jaedync/68Katalyst/README.md

# 68Katalyst

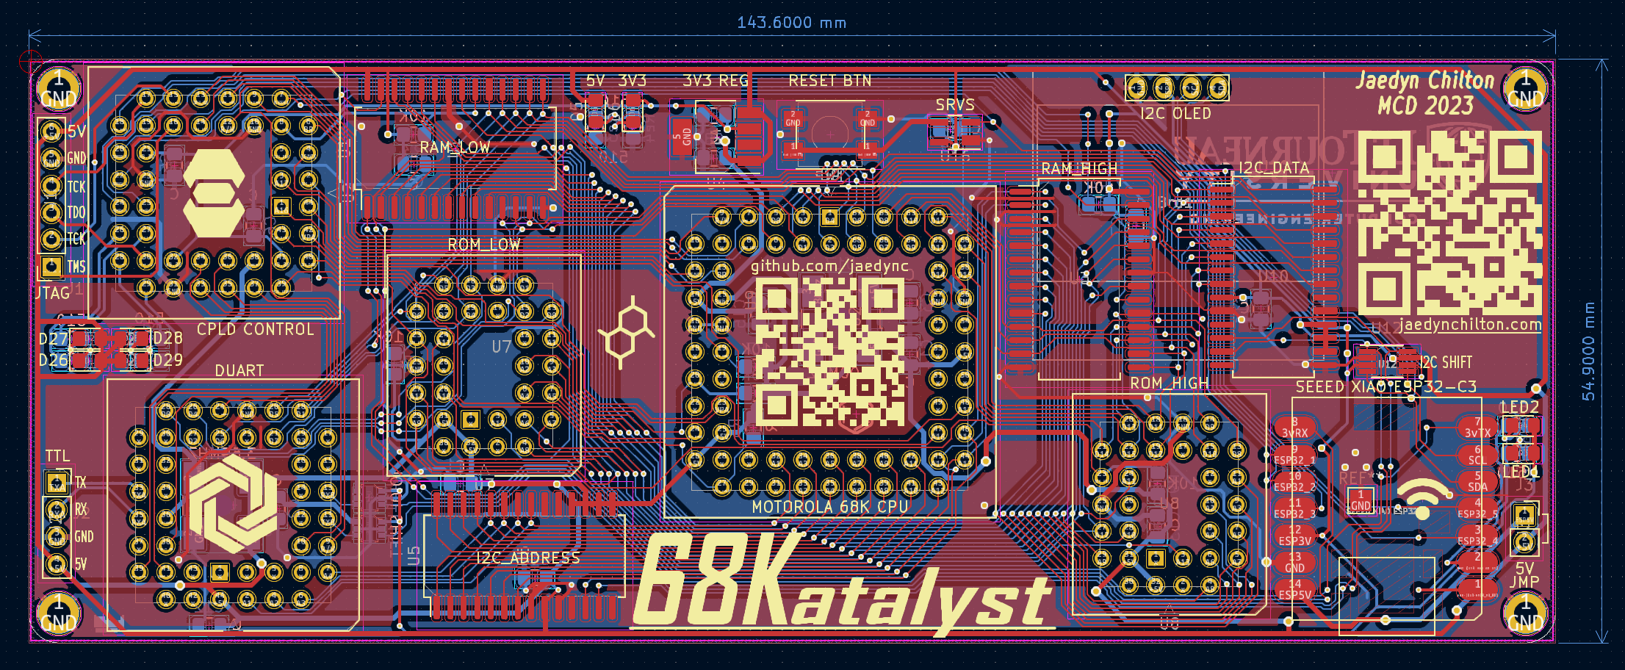
[picture p1: images/68Katalyst_PCB_Layers.png]
68Katalyst PCB Design


68Katalyst is a computer engineering project at Letourneau University. The goal is to create a turing complete 68k microcomputer that can commnicate over a serial connection.'

## Software used

- [KiCad](https://www.kicad.org/) PCB design software

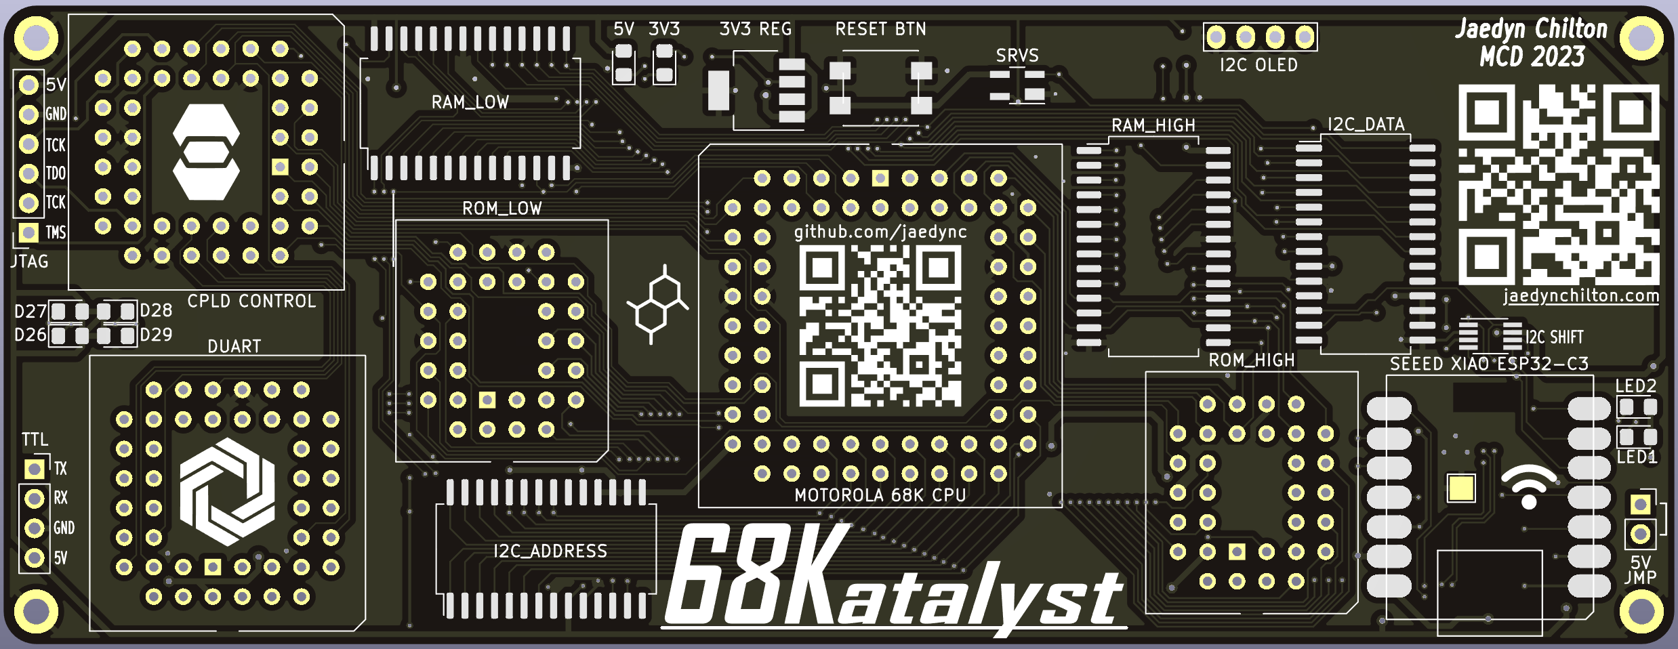
[picture p2: images/68Katalyst_PCB_Front.png]
PCB Front Render


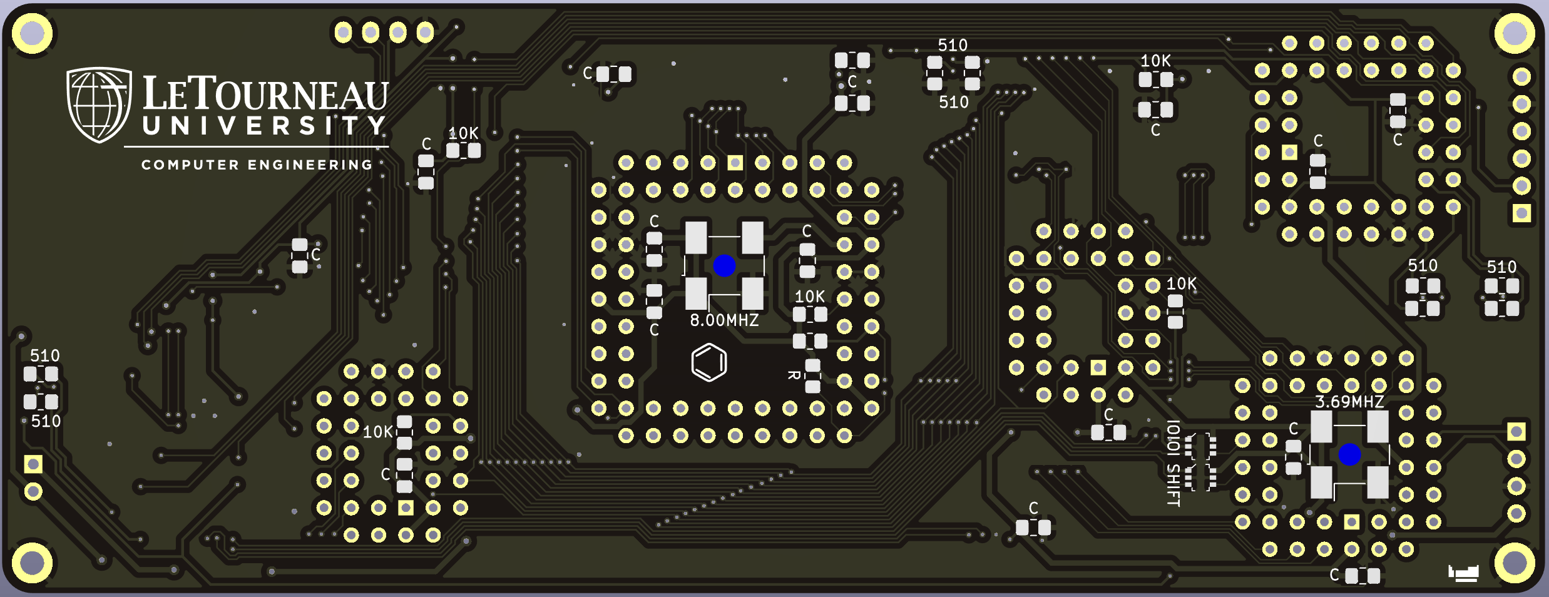
[picture p3: images/68Katalyst_PCB_Back.png]
PCB Back Render


## Contact Information

If you have any questions, feel free to reach out at me@jaedynchilton.com!
