jaedync/68Katalyst/MCD.kicad_pcb

## KiCad design MCD.kicad_pcb (2023-03-04)

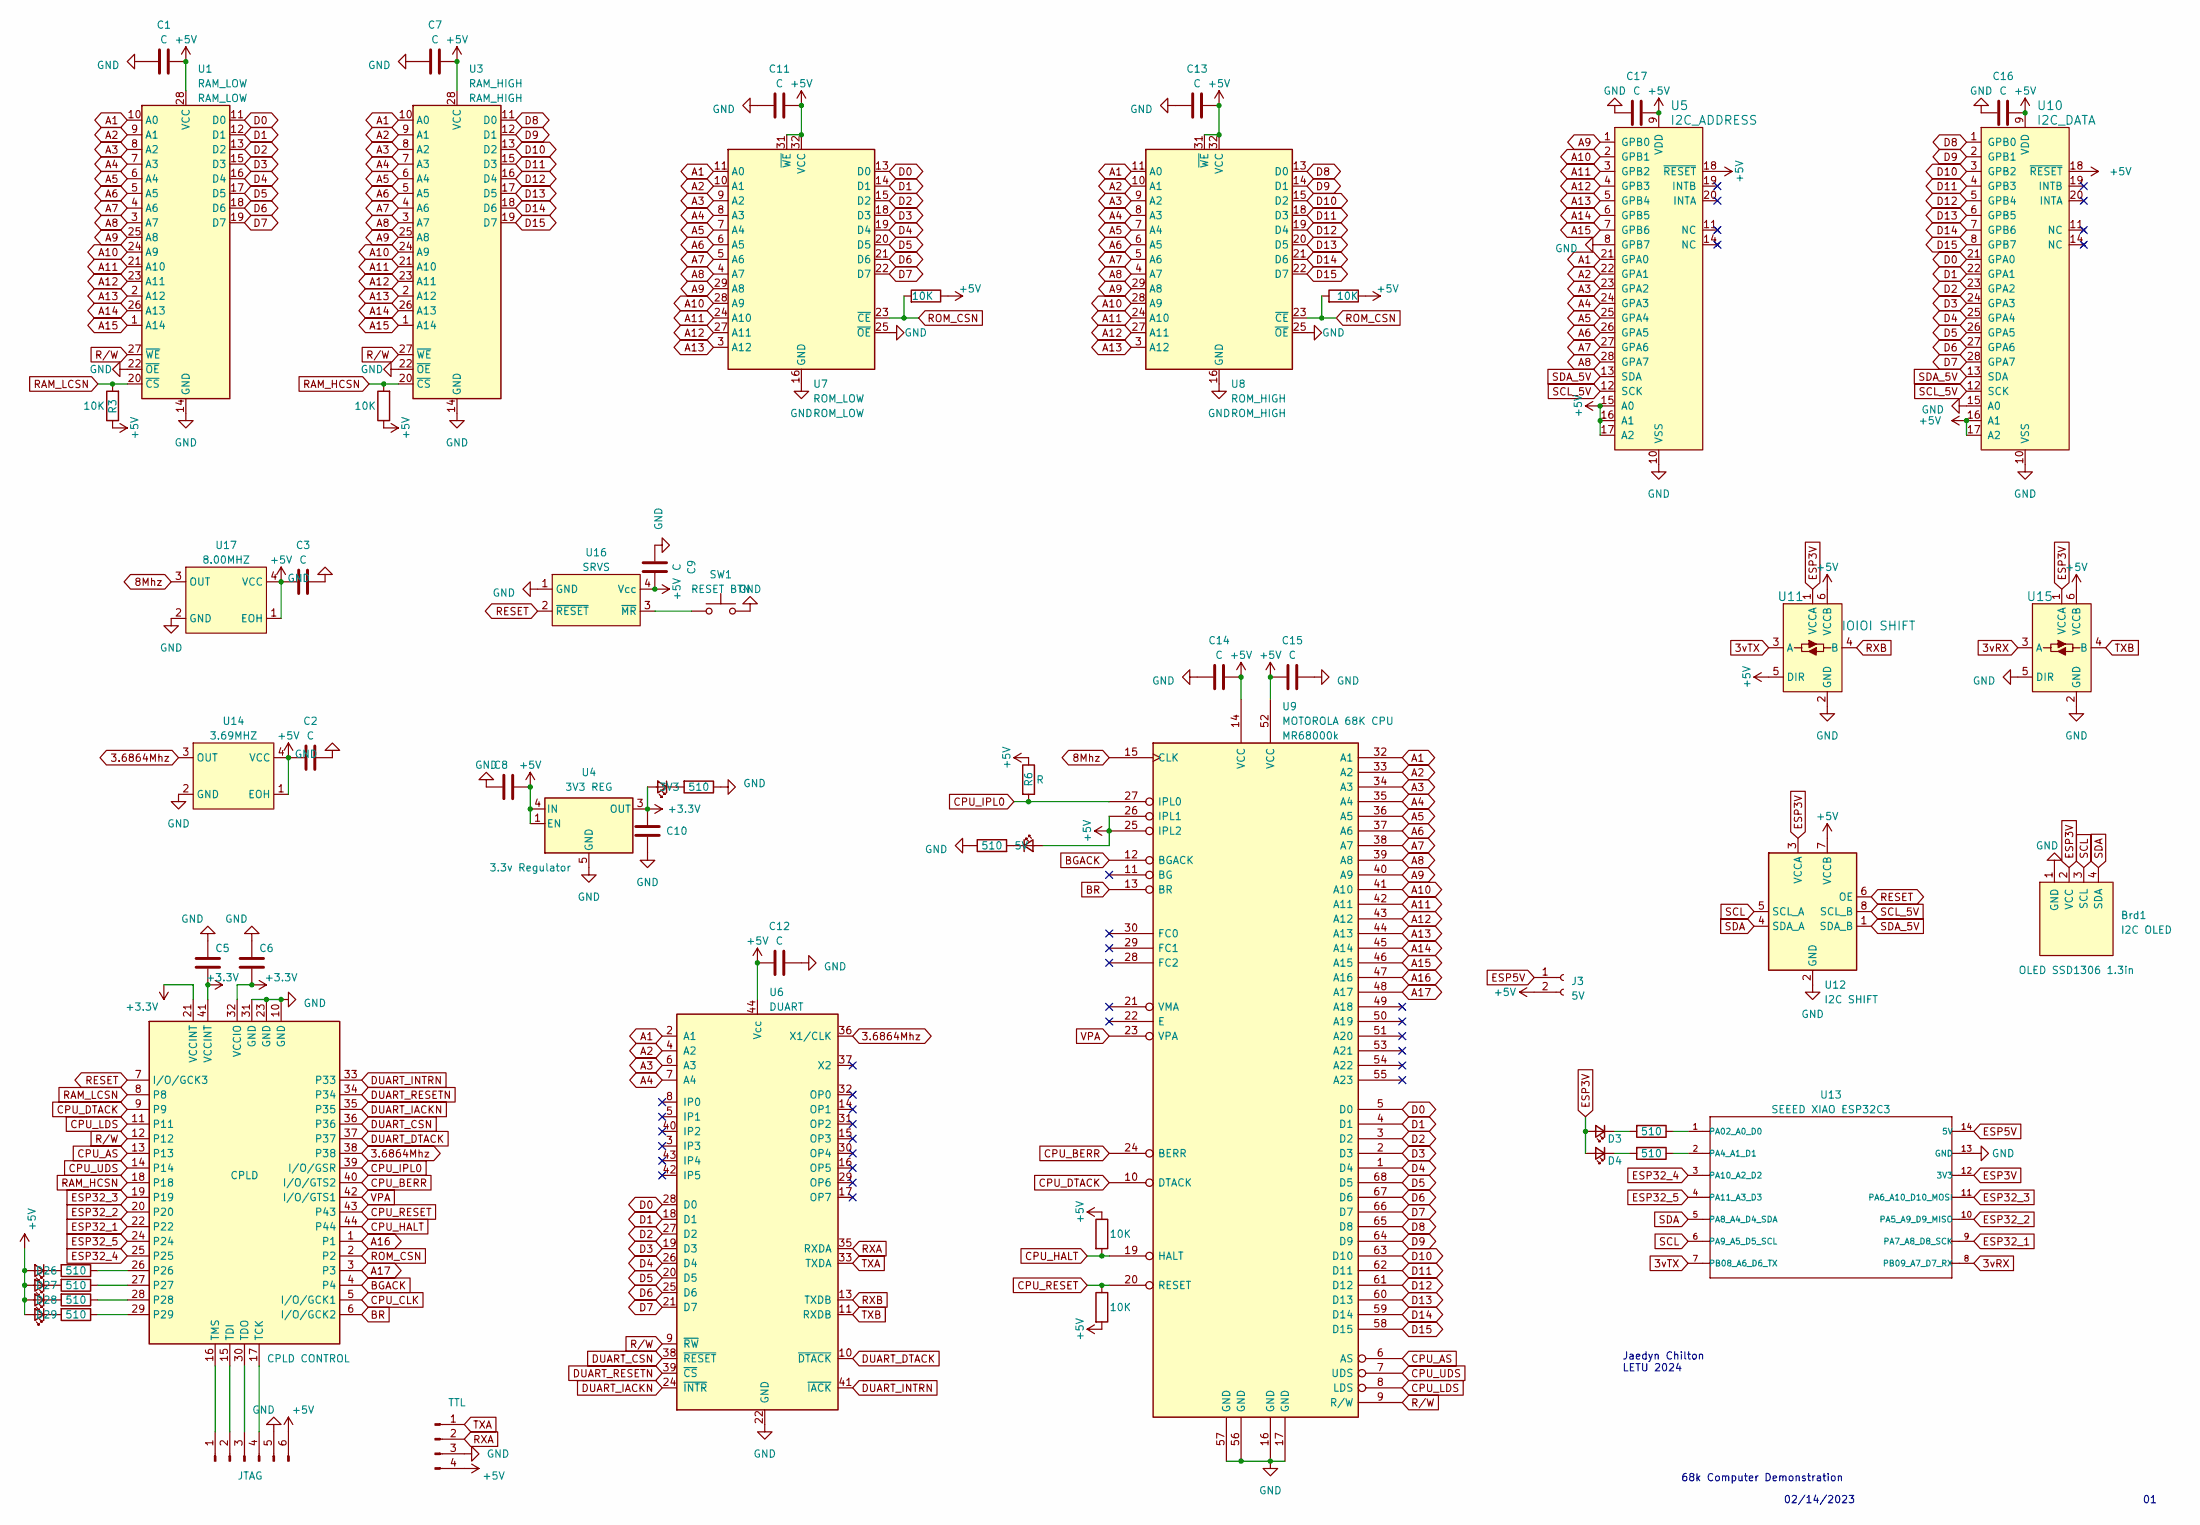
[picture p4: schematic MCD.kicad_sch]

Parts:
Brd1: I2C OLED; 128x64OLED
C1, C2, C3, C5, C6, C7, C8, C9, C10, C11, C12, C13, C14, C15, C16, C17: C; C_0805_2012Metric_Pad1.18x1.45mm_HandSolder
D1: D26; LED_0805_2012Metric_Pad1.15x1.40mm_HandSolder
D2: D27; LED_0805_2012Metric_Pad1.15x1.40mm_HandSolder
D3, D4: Green; LED_0805_2012Metric_Pad1.15x1.40mm_HandSolder
D5: 5V; LED_0805_2012Metric_Pad1.15x1.40mm_HandSolder
D6: 3V3; LED_0805_2012Metric_Pad1.15x1.40mm_HandSolder
D28: D28; LED_0805_2012Metric_Pad1.15x1.40mm_HandSolder
D29: D29; LED_0805_2012Metric_Pad1.15x1.40mm_HandSolder
J1: JTAG; PinSocket_1x06_P2.54mm_Vertical
J2: TTL; PinSocket_1x04_P2.54mm_Vertical
J3: 5V; PinSocket_1x02_P2.54mm_Vertical
R1, R2, R10, R11: 510; R_0805_2012Metric_Pad1.20x1.40mm_HandSolder
R3, R4, R5, R7, R8, R9: 10K; R_0805_2012Metric_Pad1.20x1.40mm_HandSolder
R6: R; R_0805_2012Metric_Pad1.20x1.40mm_HandSolder
Re1, Re2, Re3, Re4: 510; R_0805_2012Metric_Pad1.20x1.40mm_HandSolder
SW1: RESET BTN; SW_Push_1P1T_NO_6x6mm_H9.5mm
U1: RAM_LOW; RAM
U2: CPLD CONTROL; PLCC-44_THT-Socket
U3: RAM_HIGH; RAM
U4: 3V3 REG; SOT-223-5
U5: I2C_ADDRESS; i2c; MPN MCP23017-E/SO; Digi-Key_PN MCP23017-E/SO-ND
U6: DUART; PLCC-44_THT-Socket
U7: ROM_LOW; PLCC-32_THT-Socket
U8: ROM_HIGH; PLCC-32_THT-Socket
U9: MOTOROLA 68K CPU; PLCC-68_THT-Socket
U10: I2C_DATA; i2c; MPN MCP23017-E/SO; Digi-Key_PN MCP23017-E/SO-ND
U11, U15: IOIOI SHIFT; SOT-363; MPN SN74LVC1T45DBVR; Digi-Key_PN 296-16843-1-ND
U12: I2C SHIFT; SSOP-8_2.95x2.8mm_P0.65mm
U13: SEEED XIAO ESP32C3; MOUDLE14P-SMD-2.54-21X17.8MM
U14: 3.69MHZ; Oscillator_SMD_SeikoEpson_SG8002CA-4Pin_7.0x5.0mm_HandSolde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
U16: SRVS; SOT-143_Handsoldering
U17: 8.00MHZ; Oscillator_SMD_SeikoEpson_SG8002CA-4Pin_7.0x5.0mm_HandSolde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

Connections:
3.6864Mhz: U2.38, U6.36 (X1/CLK), U14.3 (OUT)
3vRX: U13.8 (PB09_A7_D7_RX), U15.3 (A)
3vTX: U11.3 (A), U13.7 (PB08_A6_D6_TX)
8Mhz: U9.15 (CLK), U17.3 (OUT)
+3.3V: C5.1, C6.1, C10.2, D6.2 (A), U2.21 (VCCINT), U2.32 (VCCIO), U2.41 (VCCINT), U4.3 (OUT)
+5V: C1.1, C2.2, C3.2, C7.1, C8.1, C9.1, C11.1, C12.1, C13.1, C14.1, C15.1, C16.1, C17.1, D1.2 (A), D2.2 (A), D5.2 (A), D28.2 (A), D29.2 (A), J1.6, J2.4, J3.2, R3.1, R4.1, R5.1, R6.1, R7.1, R8.2, R9.1, U1.28 (VCC), U3.28 (VCC), U4.1 (EN), U4.4 (IN), U5.9 (VDD), U5.15 (A0), U5.16 (A1), U5.17 (A2), U5.18 (~RESET), U6.44 (Vcc), U7.31 (~WE), U7.32 (VCC), U8.31 (~WE), U8.32 (VCC), U9.14 (VCC), U9.25 (IPL2), U9.26 (IPL1), U9.52 (VCC), U10.9 (VDD), U10.16 (A1), U10.17 (A2), U10.18 (~RESET), U11.5 (DIR), U11.6 (VCCB), U12.7 (VCCB), U14.1 (EOH), U14.4 (VCC), U15.6 (VCCB), U16.4 (Vcc), U17.1 (EOH), U17.4 (VCC)
A1: U1.10 (A0), U3.10 (A0), U5.21 (GPA0), U6.2 (A1), U7.11 (A0), U8.11 (A0), U9.32 (A1)
A2: U1.9 (A1), U3.9 (A1), U5.22 (GPA1), U6.4 (A2), U7.10 (A1), U8.10 (A1), U9.33 (A2)
A3: U1.8 (A2), U3.8 (A2), U5.23 (GPA2), U6.6 (A3), U7.9 (A2), U8.9 (A2), U9.34 (A3)
A4: U1.7 (A3), U3.7 (A3), U5.24 (GPA3), U6.7 (A4), U7.8 (A3), U8.8 (A3), U9.35 (A4)
A5: U1.6 (A4), U3.6 (A4), U5.25 (GPA4), U7.7 (A4), U8.7 (A4), U9.36 (A5)
A6: U1.5 (A5), U3.5 (A5), U5.26 (GPA5), U7.6 (A5), U8.6 (A5), U9.37 (A6)
A7: U1.4 (A6), U3.4 (A6), U5.27 (GPA6), U7.5 (A6), U8.5 (A6), U9.38 (A7)
A8: U1.3 (A7), U3.3 (A7), U5.28 (GPA7), U7.4 (A7), U8.4 (A7), U9.39 (A8)
A9: U1.25 (A8), U3.25 (A8), U5.1 (GPB0), U7.29 (A8), U8.29 (A8), U9.40 (A9)
A10: U1.24 (A9), U3.24 (A9), U5.2 (GPB1), U7.28 (A9), U8.28 (A9), U9.41 (A10)
A11: U1.21 (A10), U3.21 (A10), U5.3 (GPB2), U7.24 (A10), U8.24 (A10), U9.42 (A11)
A12: U1.23 (A11), U3.23 (A11), U5.4 (GPB3), U7.27 (A11), U8.27 (A11), U9.43 (A12)
A13: U1.2 (A12), U3.2 (A12), U5.5 (GPB4), U7.3 (A12), U8.3 (A12), U9.44 (A13)
A14: U1.26 (A13), U3.26 (A13), U5.6 (GPB5), U9.45 (A14)
A15: U1.1 (A14), U3.1 (A14), U5.7 (GPB6), U9.46 (A15)
A16: U2.1, U9.47 (A16)
A17: U2.3, U9.48 (A17)
BGACK: U2.4, U9.12 (BGACK)
BR: U2.6 (I/O/GCK2), U9.13 (BR)
CPU_AS: U2.13, U9.6 (AS)
CPU_BERR: U2.40 (I/O/GTS2), U9.24 (BERR)
CPU_CLK: U2.5 (I/O/GCK1)
CPU_DTACK: U2.9, U9.10 (DTACK)
CPU_HALT: R7.2, U2.44, U9.19 (HALT)
CPU_IPL0: R6.2, U2.39 (I/O/GSR), U9.27 (IPL0)
CPU_LDS: U2.11, U9.8 (LDS)
CPU_RESET: R8.1, U2.43, U9.20 (RESET)
CPU_UDS: U2.14, U9.7 (UDS)
D0: U1.11 (D0), U6.28 (D0), U7.13 (D0), U9.5 (D0), U10.21 (GPA0)
D1: U1.12 (D1), U6.18 (D1), U7.14 (D1), U9.4 (D1), U10.22 (GPA1)
D2: U1.13 (D2), U6.27 (D2), U7.15 (D2), U9.3 (D2), U10.23 (GPA2)
D3: U1.15 (D3), U6.19 (D3), U7.18 (D3), U9.2 (D3), U10.24 (GPA3)
D4: U1.16 (D4), U6.26 (D4), U7.19 (D4), U9.1 (D4), U10.25 (GPA4)
D5: U1.17 (D5), U6.20 (D5), U7.20 (D5), U9.68 (D5), U10.26 (GPA5)
D6: U1.18 (D6), U6.25 (D6), U7.21 (D6), U9.67 (D6), U10.27 (GPA6)
D7: U1.19 (D7), U6.21 (D7), U7.22 (D7), U9.66 (D7), U10.28 (GPA7)
D8: U3.11 (D0), U8.13 (D0), U9.65 (D8), U10.1 (GPB0)
D9: U3.12 (D1), U8.14 (D1), U9.64 (D9), U10.2 (GPB1)
D10: U3.13 (D2), U8.15 (D2), U9.63 (D10), U10.3 (GPB2)
D11: U3.15 (D3), U8.18 (D3), U9.62 (D11), U10.4 (GPB3)
D12: U3.16 (D4), U8.19 (D4), U9.61 (D12), U10.5 (GPB4)
D13: U3.17 (D5), U8.20 (D5), U9.60 (D13), U10.6 (GPB5)
D14: U3.18 (D6), U8.21 (D6), U9.59 (D14), U10.7 (GPB6)
D15: U3.19 (D7), U8.22 (D7), U9.58 (D15), U10.8 (GPB7)
DUART_CSN: U2.36, U6.38 (~RESET)
DUART_DTACK: U2.37, U6.10 (~DTACK)
DUART_IACKN: U2.35, U6.24 (~INTR)
DUART_INTRN: U2.33, U6.41 (~IACK)
DUART_RESETN: U2.34, U6.39 (~CS)
ESP3V: Brd1.2 (VCC), D3.2 (A), D4.2 (A), U11.1 (VCCA), U12.3 (VCCA), U13.12 (3V3), U15.1 (VCCA)
ESP5V: J3.1, U13.14 (5V)
ESP32_1: U2.22, U13.9 (PA7_A8_D8_SCK)
ESP32_2: U2.20, U13.10 (PA5_A9_D9_MISO)
ESP32_3: U2.19, U13.11 (PA6_A10_D10_MOSI)
ESP32_4: U2.25, U13.3 (PA10_A2_D2)
ESP32_5: U2.24, U13.4 (PA11_A3_D3)
GND: Brd1.1 (GND), C1.2, C2.1, C3.1, C5.2, C6.2, C7.2, C8.2, C9.2, C10.1, C11.2, C12.2, C13.2, C14.2, C15.2, C16.2, C17.2, J1.5, J2.3, Re3.1, Re4.1, SW1.2, U1.14 (GND), U1.22 (~OE), U2.10 (GND), U2.23 (GND), U2.31 (GND), U3.14 (GND), U3.22 (~OE), U4.5 (GND), U5.8 (GPB7), U5.10 (VSS), U6.22 (GND), U7.16 (GND), U7.25 (~OE), U8.16 (GND), U8.25 (~OE), U9.16 (GND), U9.17 (GND), U9.56 (GND), U9.57 (GND), U10.10 (VSS), U10.15 (A0), U11.2 (GND), U12.2 (GND), U13.13 (GND), U14.2 (GND), U15.2 (GND), U15.5 (DIR), U16.1 (GND), U17.2 (GND)
unnamed: D1.1 (K), R2.2
unnamed: D2.1 (K), Re2.2
unnamed: D3.1 (K), R10.2
unnamed: D4.1 (K), R11.2
unnamed: D5.1 (K), Re3.2
unnamed: D6.1 (K), Re4.2
unnamed: D28.1 (K), R1.2
unnamed: D29.1 (K), Re1.2
unnamed: J1.1, U2.16 (TMS)
unnamed: J1.2, U2.15 (TDI)
unnamed: J1.3, U2.30 (TDO)
unnamed: J1.4, U2.17 (TCK)
unnamed: R2.1, U2.26
unnamed: Re2.1, U2.27
unnamed: R1.1, U2.28
unnamed: Re1.1, U2.29
unnamed: R10.1, U13.1 (PA02_A0_D0)
unnamed: R11.1, U13.2 (PA4_A1_D1)
unnamed: SW1.1, U16.3 (~MR)
RAM_HCSN: R4.2, U2.18, U3.20 (~CS)
RAM_LCSN: R3.2, U1.20 (~CS), U2.8
RESET: U2.7 (I/O/GCK3), U12.6 (OE), U16.2 (~RESET)
ROM_CSN: R5.2, R9.2, U2.2, U7.23 (~CE), U8.23 (~CE)
RXA: J2.2, U6.35 (RXDA)
RXB: U6.13 (TXDB), U11.4 (B)
R/W: U1.27 (~WE), U2.12, U3.27 (~WE), U6.9 (~RW), U9.9 (R/W)
SCL: Brd1.3 (SCL), U12.5 (SCL_A), U13.6 (PA9_A5_D5_SCL)
SCL_5V: U5.12 (SCK), U10.12 (SCK), U12.8 (SCL_B)
SDA: Brd1.4 (SDA), U12.4 (SDA_A), U13.5 (PA8_A4_D4_SDA)
SDA_5V: U5.13 (SDA), U10.13 (SDA), U12.1 (SDA_B)
TXA: J2.1, U6.33 (TXDA)
TXB: U6.11 (RXDB), U15.4 (B)
VPA: U2.42 (I/O/GTS1), U9.23 (VPA)

Notes on the sheet:
Jaedyn Chilton LETU 2024
02/14/2023
68k Computer Demonstration

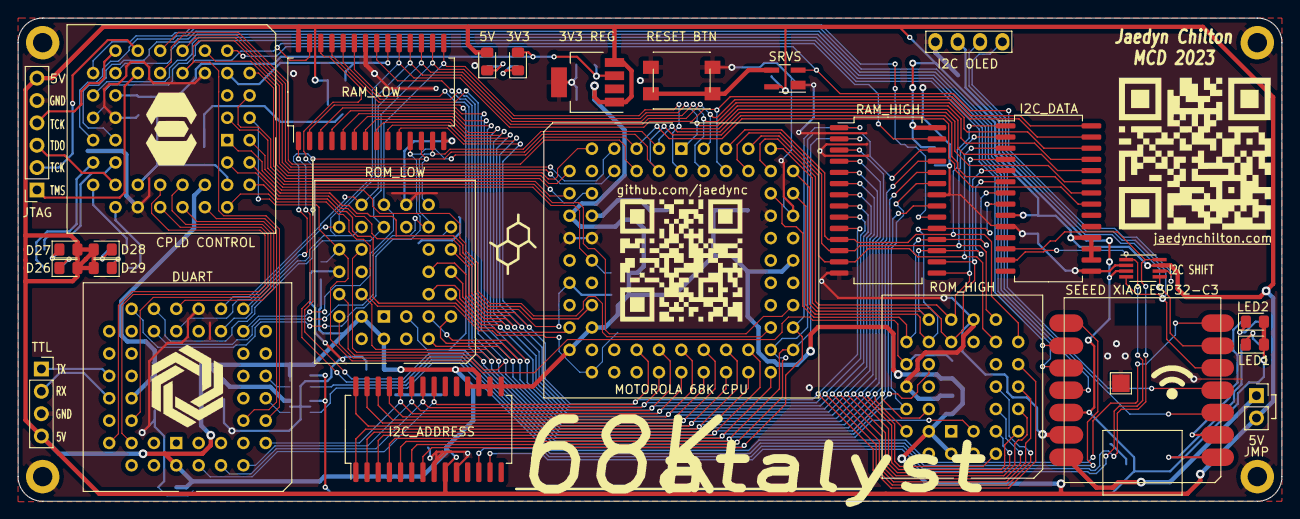
[picture p5: board MCD.kicad_pcb from above]

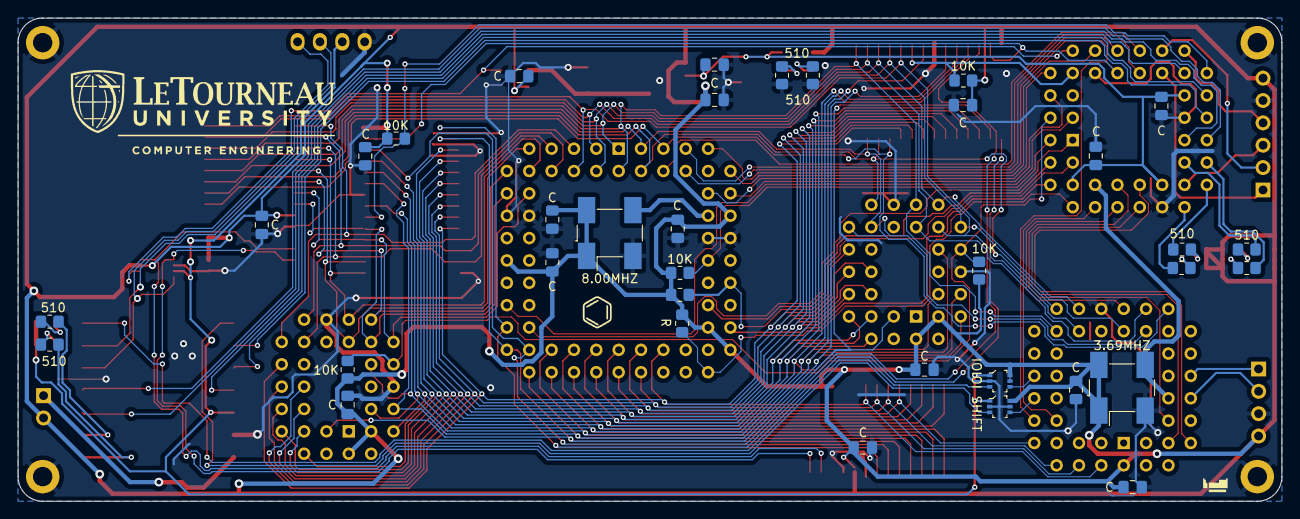
[picture p6: board MCD.kicad_pcb from below]

Board: 2 copper layers, 143.6 x 54.9 mm, 61 parts (35 on the bottom side), 95 nets.
