jaedync/68Katalyst/(commit log)

2023-03-03 68Katalyst 1.0
    First revision of board.
    [MCD-B_Cu.gbl, MCD-B_Mask.gbs, MCD-B_Paste.gbp, MCD-B_Silkscreen.gbo, MCD-Edge_Cuts.gm1, MCD-F_Cu.gtl, MCD-F_Mask.gts, MCD-F_Paste.gtp]
2023-03-04 Rev 1.1
    Added pictures of PCB and readme
    [MCD.kicad_pcb, MCD.kicad_sch]
